another-greg/MT6835_encoder_breakout_board/magnetic encoder board outline and mounting holes 30mm.dxf

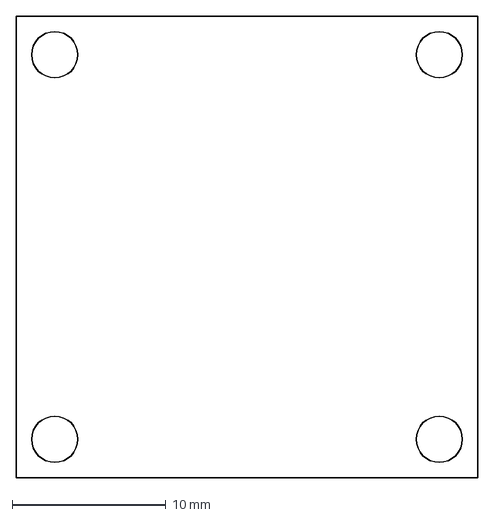
[picture p4: CAD file, 2026-04-14]
magnetic encoder board outline and mounting holes 30mm.dxf
30.0 x 30.0 mm
