another-greg/MT6835_encoder_breakout_board/magnetic_encoder_schematic.pdf

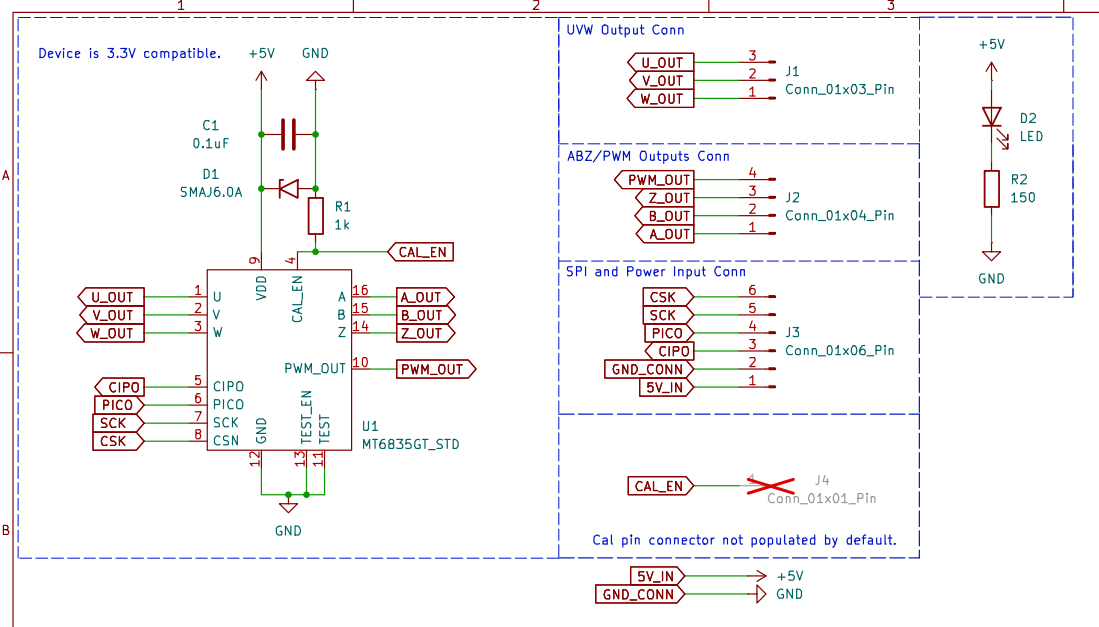
[picture p5: page 1]
