another-greg/MT6835_encoder_breakout_board/magnetic_encoder.kicad_pcb

## KiCad design magnetic_encoder.kicad_pcb (2026-04-14)

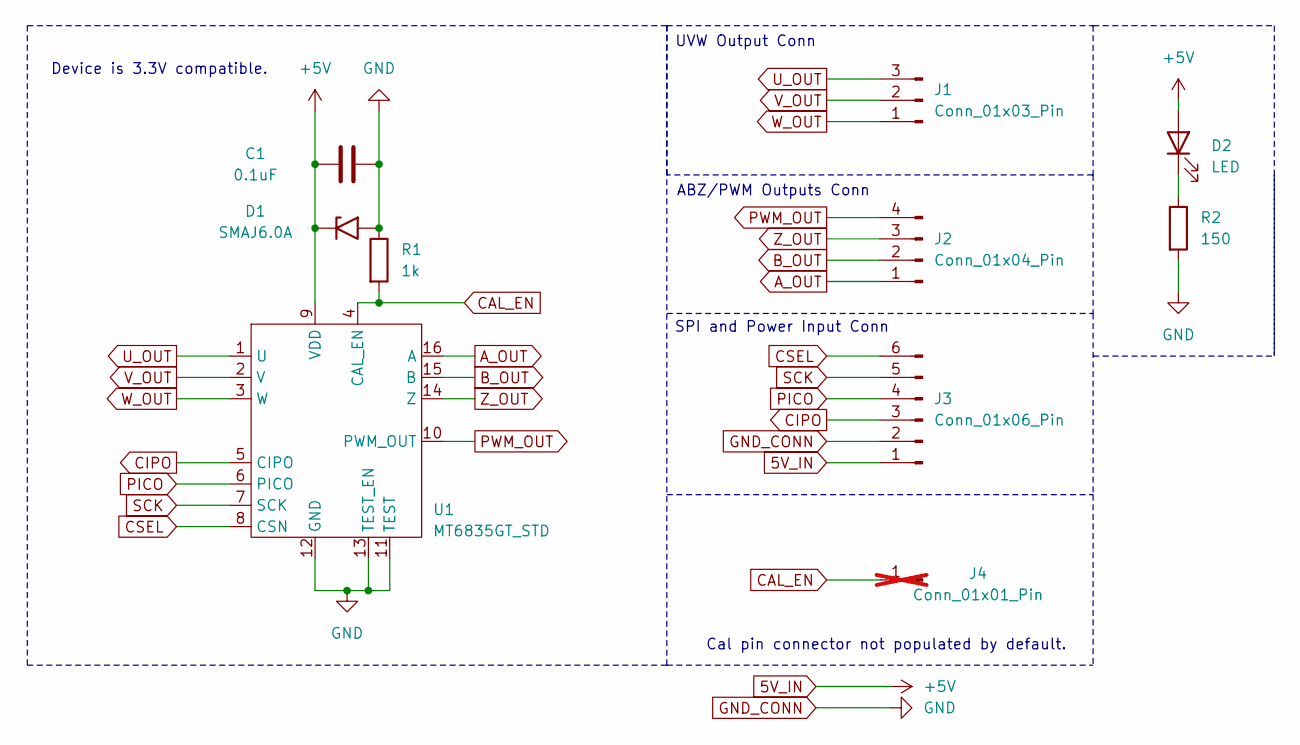
[picture p6: schematic magnetic_encoder.kicad_sch]

Parts:
C1: 0.1uF; C_0603_1608Metric
D1: SMAJ6.0A; D_SMA
D2: LED; LED_0603_1608Metric
J1: Conn_01x03_Pin; JST_PH_S3B-PH-SM4-TB_1x03-1MP_P2.00mm_Horizontal
J2: Conn_01x04_Pin; JST_PH_S4B-PH-SM4-TB_1x04-1MP_P2.00mm_Horizontal
J3: Conn_01x06_Pin; JST_PH_S6B-PH-SM4-TB_1x06-1MP_P2.00mm_Horizontal
J4: Conn_01x01_Pin; PinHeader_1x01_P2.54mm_Vertical; not fitted
R1: 1k; R_0402_1005Metric
R2: 150; R_0402_1005Metric
U1: MT6835GT_STD; TSSOP-16_4.4x5mm_P0.65mm

Connections:
5V_IN: C1.1, D1.1 (A1), D2.2 (A), J3.1, U1.9 (VDD)
A_OUT: J2.1, U1.16 (A)
B_OUT: J2.2, U1.15 (B)
CAL_EN: J4.1, R1.2, U1.4 (CAL_EN)
CIPO: J3.3, U1.5 (CIPO)
CSEL: J3.6, U1.8 (CSN)
GND_CONN: C1.2, D1.2 (A2), J3.2, R1.1, R2.2, U1.11 (TEST), U1.12 (GND), U1.13 (TEST_EN)
unnamed: D2.1 (K), R2.1
PICO: J3.4, U1.6 (PICO)
PWM_OUT: J2.4, U1.10 (PWM_OUT)
SCK: J3.5, U1.7 (SCK)
U_OUT: J1.3, U1.1 (U)
V_OUT: J1.2, U1.2 (V)
W_OUT: J1.1, U1.3 (W)
Z_OUT: J2.3, U1.14 (Z)

Notes on the sheet:
Cal pin connector not populated by default.
ABZ/PWM Outputs Conn
SPI and Power Input Conn
Device is 3.3V compatible.
UVW Output Conn

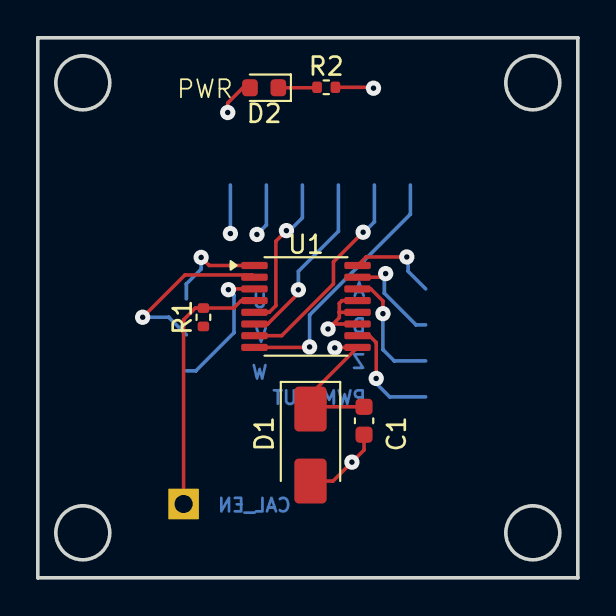
[picture p7: board magnetic_encoder.kicad_pcb from above]

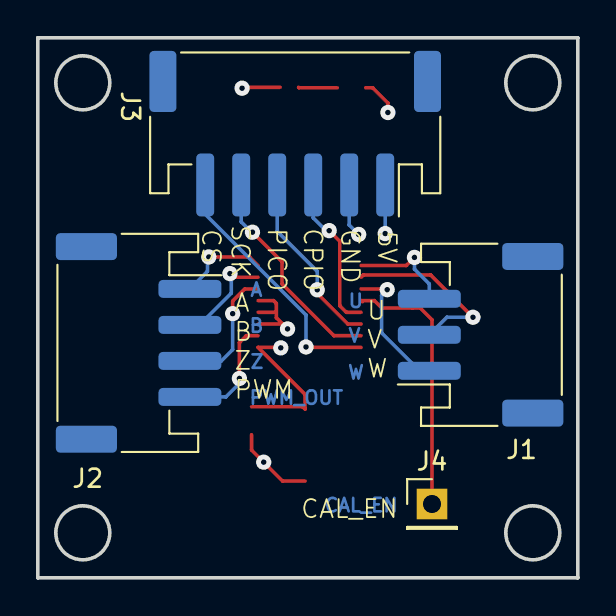
[picture p8: board magnetic_encoder.kicad_pcb from below]

Board: 4 copper layers, 30.0 x 30.0 mm, 10 parts (4 on the bottom side), 15 nets.
