another-greg/MT6835_encoder_breakout_board/(commit log)

2026-04-14 add image of schematic
2026-04-14 added labels to pins
    [magnetic_encoder-CuBottom.gbr, magnetic_encoder-CuIn1.gbr, magnetic_encoder-CuIn2.gbr, magnetic_encoder-CuTop.gbr, magnetic_encoder-EdgeCuts.gbr, magnetic_encoder-MaskBottom.gbr, magnetic_encoder-MaskTop.gbr, magnetic_encoder-NPTH.drl]
